Rithvik227/RC-Car-IMU-vs-CV-motion-tracker/Hardware/Circuit Schematics/IMU_vs_CV_tracker_schematic_no_drawing_sheet.pdf

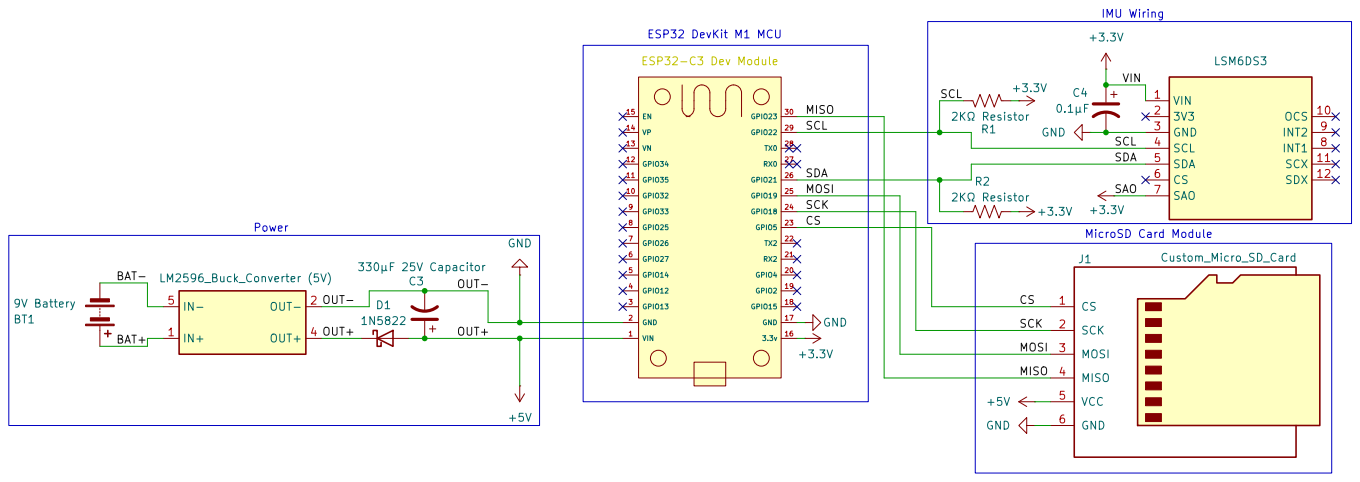
[picture p5: page 1]
