Rithvik227/RC-Car-IMU-vs-CV-motion-tracker/(commit log)

2026-10-24 Added circuit schematic
2026-10-27 Reorganize repo to match local folder
    [cv_data_001.csv, cv_data_002.csv, cv_data_003.csv, cv_data_004.csv, cv_data_005.csv, cv_data_006.csv, cv_data_007.csv, cv_data_008.csv]
2026-10-27 Add README, figures, and schematic image
